cbpmckinney/ece568rockets/ground_station/pcb/ground_station.kicad_pcb

## KiCad design ground_station/pcb/ground_station.kicad_pcb (2025-05-07)

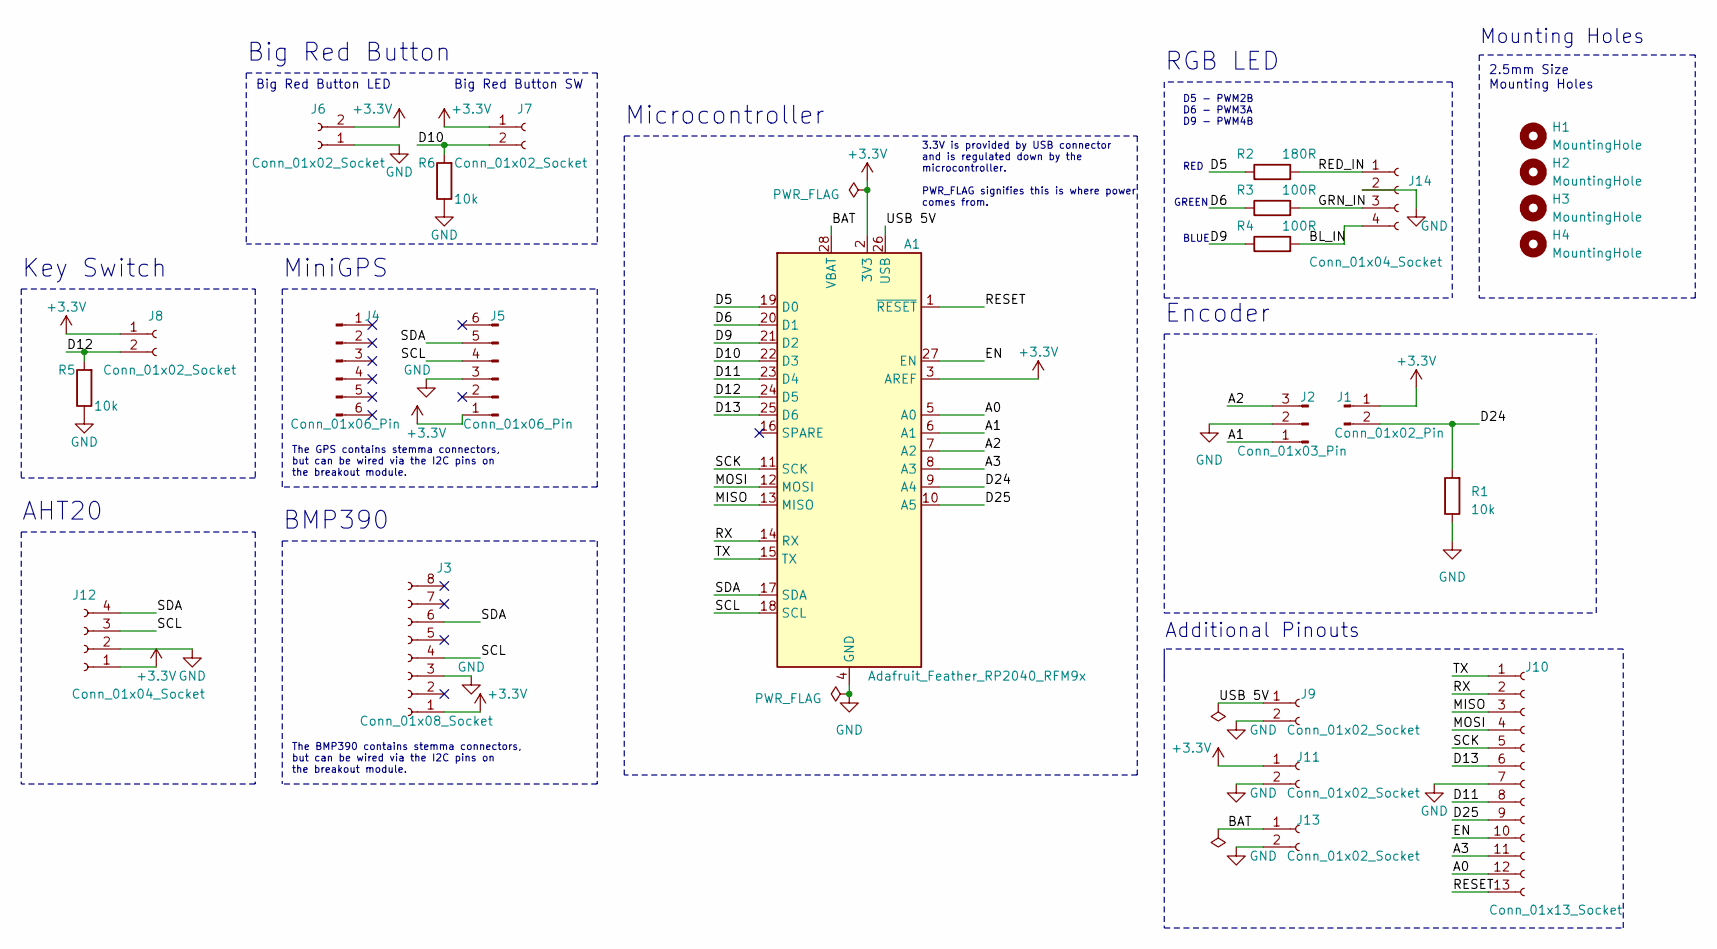
[picture p7: schematic ground_station.kicad_sch, ECE568 Ground Station]

Parts:
A1: Adafruit_Feather_RP2040_RFM9x; Adafruit_Feather
H1, H2, H3, H4: MountingHole; MountingHole_2.5mm
J1: Conn_01x02_Pin; PinHeader_1x02_P2.54mm_Vertical
J2: Conn_01x03_Pin; PinHeader_1x03_P2.54mm_Vertical
J3: Conn_01x08_Socket; PinSocket_1x08_P2.54mm_Vertical
J4, J5: Conn_01x06_Pin; PinHeader_1x06_P2.54mm_Vertical
J6, J7, J8, J9, J11, J13: Conn_01x02_Socket; PinSocket_1x02_P2.54mm_Vertical
J10: Conn_01x13_Socket; PinSocket_1x13_P2.54mm_Vertical
J12, J14: Conn_01x04_Socket; PinSocket_1x04_P2.54mm_Vertical
R1, R5, R6: 10k; R_Axial_DIN0309_L9.0mm_D3.2mm_P2.54mm_Vertical
R2: 180R; R_Axial_DIN0309_L9.0mm_D3.2mm_P2.54mm_Vertical
R3, R4: 100R; R_Axial_DIN0309_L9.0mm_D3.2mm_P2.54mm_Vertical

Connections:
+3.3V: A1.2 (3V3), A1.3 (AREF), J1.1, J3.1, J5.1, J6.2, J7.1, J8.1, J11.1, J12.1
/A0: A1.5 (A0), J10.12
/A1: A1.6 (A1), J2.1
/A2: A1.7 (A2), J2.3
/A3: A1.8 (A3), J10.11
/BAT: A1.28 (VBAT), J13.1
/BL_IN: J14.4, R4.2
/D5: A1.19 (D0), R2.1
/D6: A1.20 (D1), R3.1
/D9: A1.21 (D2), R4.1
/D10: A1.22 (D3), J7.2, R6.2
/D11: A1.23 (D4), J10.8
/D12: A1.24 (D5), J8.2, R5.2
/D13: A1.25 (D6), J10.6
/D24: A1.9 (A4), J1.2, R1.2
/D25: A1.10 (A5), J10.9
/EN: A1.27 (EN), J10.10
/GRN_IN: J14.3, R3.2
/MISO: A1.13 (MISO), J10.3
/MOSI: A1.12 (MOSI), J10.4
/RED_IN: J14.1, R2.2
/RESET: A1.1 (~RESET), J10.13
/RX: A1.14 (RX), J10.2
/SCK: A1.11 (SCK), J10.5
/SCL: A1.18 (SCL), J3.4, J5.4, J12.3
/SDA: A1.17 (SDA), J3.6, J5.5, J12.4
/TX: A1.15 (TX), J10.1
/USB 5V: A1.26 (USB), J9.1
GND: A1.4 (GND), J2.2, J3.3, J5.3, J6.1, J9.2, J10.7, J11.2, J12.2, J13.2, J14.2, R1.1, R5.1, R6.1

Notes on the sheet:
The GPS contains stemma connectors, but can be wired via the I2C pins on the breakout module.
Additional Pinouts
Big Red Button LED
RGB LED
2.5mm Size Mounting Holes
Encoder
Microcontroller
3.3V is provided by USB connector and is regulated down by the microcontroller. PWR_FLAG signifies this is where power comes from.
The BMP390 contains stemma connectors, but can be wired via the I2C pins on the breakout module.
Mounting Holes
Big Red Button
AHT20
Key Switch
BMP390
RED
GREEN
BLUE
Big Red Button SW
MiniGPS
D5 - PWM2B D6 - PWM3A D9 - PWM4B

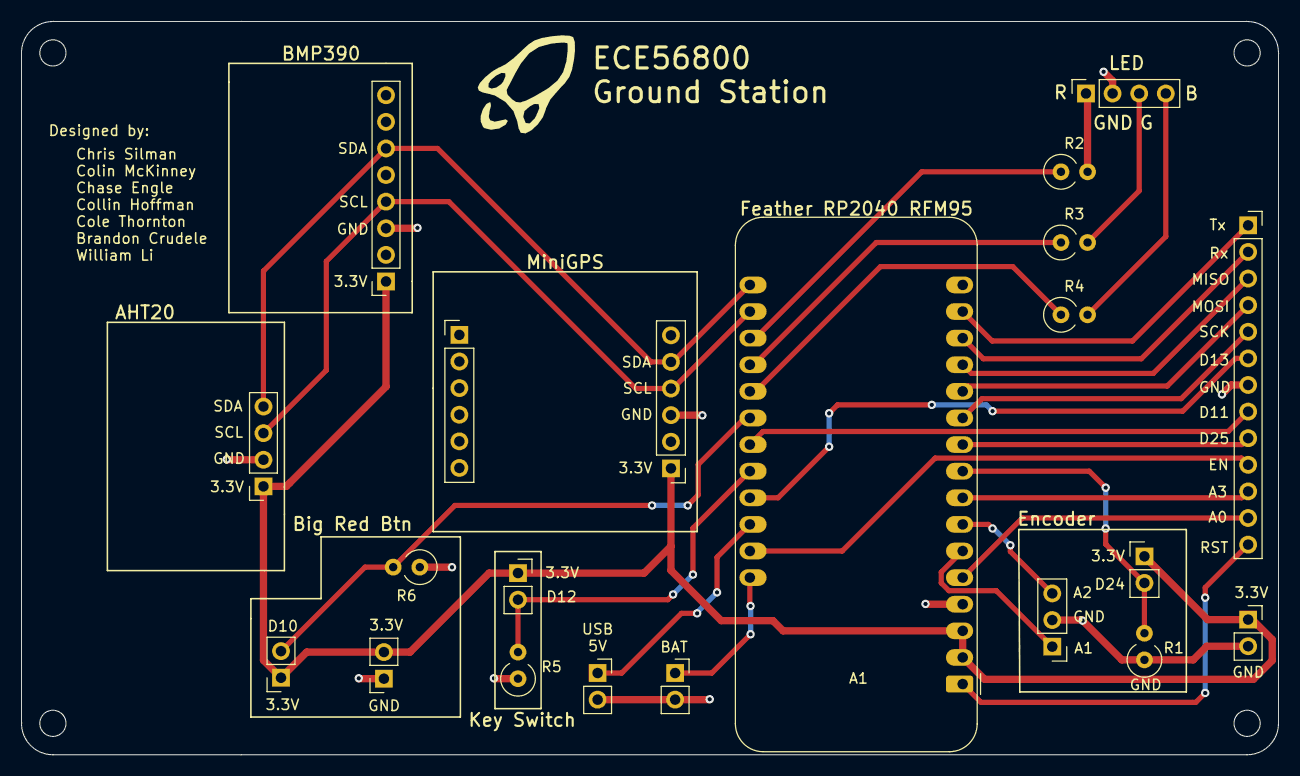
[picture p8: board ground_station.kicad_pcb from above]

Board: 2 copper layers, 120.0 x 70.0 mm, 25 parts (0 on the bottom side), 29 nets.
