cbpmckinney/ece568rockets/FlightComputer/main/main.ino

#include "main.h"
#include "Sensor.h"
#include "DOFSensor.h"
#include "altitudeSensor.h"
#include "temperatureSensor.h"
#include "RFManager.h"
#include <SPI.h>
#include <RH_RF95.h>
#include <RHReliableDatagram.h>
//#include <Wire.h>
#include <Adafruit_GPS.h>

#include <hardware/regs/m0plus.h>
#include <hardware/regs/addressmap.h>
#include <hardware/resets.h>

volatile bool ignitionFailure = false;

inline void reboot() {
    //reset USB controller
    reset_block(RESETS_WDSEL_USBCTRL_BITS);
    //you might want to add other perpherials here if you use them

    //reset the CPU
    auto & AIRCR_register = *(volatile uint32_t*)(PPB_BASE + M0PLUS_AIRCR_OFFSET);
    //From datasheet:
    //31:16 VECTKEY: On writes, write 0x05FA to VECTKEY, otherwise the write is ignored.
    //15 ENDIANESS: 0 = Little-endian.
    //14:3 Reserved
    //2 SYSRESETREQ: Writing 1 to this bit causes the SYSRESETREQ signal to the outer system to be asserted to request a reset.
    //1 VECTCLRACTIVE: not relevant here
    AIRCR_register = (0x05FA << M0PLUS_AIRCR_VECTKEY_LSB) | M0PLUS_AIRCR_SYSRESETREQ_BITS;
}



#ifdef TEST_MODE_ON_GROUND
  uint8_t simAltitude = 0;
#endif

#define DEBUG 1
#define RelayPin 25
#define GPSECHO false

Adafruit_GPS GPS(&Wire);
uint32_t timer = millis();

GPSDataStorage RocketGPSData;

void setup() {
#ifdef DEBUG
  Serial.begin(115200);

  //while (!Serial) delay(10);  // wait for serial port to open!
  
#endif
  pinMode(RelayPin, OUTPUT); // relay output pin
  digitalWrite(RelayPin, LOW); // set relay to off
  Serial.println("Initializing GPS");
  GPS.begin(0x10);
  GPS.sendCommand(PMTK_SET_NMEA_OUTPUT_RMCGGA);
  GPS.sendCommand(PMTK_SET_NMEA_UPDATE_1HZ);
  GPS.sendCommand(PGCMD_ANTENNA);
  delay(1000);
  GPS.println(PMTK_Q_RELEASE);
  // put your setup code here, to run once:
}

alarm_id_t TimerID;
int64_t RelayCallback(alarm_id_t id, void *user_data)
{
  ignitionFailure = true;
  return 0;
}



void loop() {
  static rocket_states_t currRocketState = BOOTUP;
  static sensorStatus statusByte;
  static DOFSensor dofSensor;
  static AltitudeSensor altitude_sensor;
  static TemperatureSensor temperature_sensor;
  static Sensor gps;

  static RFManager rfManager;
  static bool armCommandReceived = false;
  static bool readyCommandReceived = false;
  static bool launchCommandReceived = false;
  static bool verifyDataCommandReceived = false;
  static bool reinitializeCommandReceived = false;
  #define DEBUG 1
  #ifdef DEBUG
    static bool firstEntry = true;
  #endif

  #ifdef TEST_MODE_ON_GROUND
  static bool isFlying = false;
  static bool doneFlying = false;
  #endif

  static bool recoveryStarted = false;
  static int resetmessagecounter = 0;

  switch( currRocketState )
  {
      case POWERONFAILURE:
        #ifdef DEBUG
          Serial.println("Power On Failure...");
          Serial.println("Going back to BOOTUP");
        #endif
        currRocketState = BOOTUP;
        delay(1000);
        break;
      case BOOTUP:
        #ifdef DEBUG
          if( firstEntry )
          {
            firstEntry = false;
            Serial.println("ROCKET IN BOOTUP");

          }
        #endif
        statusByte.bits.dof_sensor         = dofSensor.initialize();   // testing without DOF
        statusByte.bits.altitude_sensor    = altitude_sensor.initialize();
        statusByte.bits.temperature_sensor = temperature_sensor.initialize();
        statusByte.bits.gps                = gps.initialize(); 
        statusByte.bits.RFtransmitter      = rfManager.initialize();
        if(statusByte.byte == 0)
        {
        #ifdef DEBUG
          firstEntry = true;
        #endif
          currRocketState = SAFE;
          Serial.println("Going to SAFE mode...");
          rfManager.sendStatus( statusByte, currRocketState );
          //currRocketState = RECOVERY; // just for testingå
        }
        else
        {
          currRocketState = POWERONFAILURE;
          Serial.println("Power On Failure...");
          rfManager.sendStatus( statusByte, currRocketState );
        }
        // THE ELSE IS ASSUMING WE WILL SEND A RADIO SIGNAL THAT SOMETHING IS WRONG
        break;

      case SAFE:
        #ifdef DEBUG
          if( firstEntry )
          {
            firstEntry = false;
            Serial.println("ROCKET IN SAFE");
          }
        #endif 

        static uint32_t timer_safe = millis();
        if (millis() - timer_safe > 1000)
        {
          rfManager.sendStatus(statusByte, currRocketState);
          timer_safe = millis();
        }


        if( rfManager.receivedCommand( ARM_PACKET ) )
        {
          Serial.println("ARM Packet Received from Ground Station");
          armCommandReceived = true;
        }
        if( armCommandReceived )
        {
          //delay(1000);
        #ifdef DEBUG
          firstEntry = true;
        #endif
          currRocketState = ARM;
          Serial.println("Sending ARM ACK to Ground Station");
          rfManager.sendStatus( statusByte, currRocketState );
        }
        break;

      case ARM:
        #ifdef DEBUG
            if( firstEntry )
            {
              firstEntry = false;
              Serial.println("ROCKET IN ARM");
              statusByte.bits.dof_sensor         = dofSensor.setInitialDataValues();
              statusByte.bits.altitude_sensor    = altitude_sensor.setInitialDataValues();
              statusByte.bits.temperature_sensor = temperature_sensor.setInitialDataValues();
              statusByte.bits.gps                = gps.setInitialDataValues();
            }
        #endif
        // receive cmd to put rocket in ready to launch mode:
        if( rfManager.receivedCommand( RTL_PACKET ) )
        {
          Serial.println("--Ready to Launch-- Packet Received from Ground Station");
          readyCommandReceived = true;
        }
        if ( readyCommandReceived ) {
          #ifdef DEBUG
            firstEntry = true;
          #endif
          currRocketState = READY_FOR_LAUNCH;
          Serial.println("Sending READY_TO_LAUNCH status to Ground Station");
          rfManager.sendStatus( statusByte, currRocketState );
        } 
        break;
      case READY_FOR_LAUNCH:
        #ifdef DEBUG
            if( firstEntry )
            {
              firstEntry = false;
              Serial.println("Ready for launch!");
            }
        #endif
        // receive cmd to put rocket in ready to launch mode:
        if( rfManager.receivedCommand( LAUNCH_PACKET ) )
          {
            Serial.println("--Launch-- Packet Received from Ground Station");
            launchCommandReceived = true;
          }
        if ( launchCommandReceived ) {
          #ifdef DEBUG
            firstEntry = true;
          #endif
          currRocketState = LAUNCH;
          Serial.println("Sending LAUNCH status to Ground Station");
          rfManager.sendStatus( statusByte, currRocketState );
          Serial.println("Launch ACK sent");
        } 
        break;


      case LAUNCH:
        //#ifdef DEBUG I need this to run regardless of debugging, so the timer only gets started once
          if ( firstEntry )
          {
            firstEntry = false;
            Serial.println("ROCKET IN LAUNCH");
            digitalWrite(RelayPin, HIGH); // fires relay
            TimerID = add_alarm_in_ms(10000, RelayCallback, NULL, false);
          }
        //#endif

        #ifdef TEST_MODE_ON_GROUND
        if( isFlying )
        {
          #ifdef DEBUG
          firstEntry = true;
          #endif
          currRocketState = FLIGHT;
          Serial.println("ROCKET IN FLIGHT");
          rfManager.sendStatus( statusByte, currRocketState );
        }
        #else
        if( dofSensor.isFlying() )
        {
          #ifdef DEBUG
            firstEntry = true;
          #endif
          currRocketState = FLIGHT;
          Serial.println("ROCKET IN FLIGHT");
          rfManager.sendStatus( statusByte, currRocketState );
        }
        #endif

        if (ignitionFailure)
        {
          digitalWrite(RelayPin, LOW);
          Serial.println("Ingition failure detected");
          currRocketState = IGNITIONFAILURE;
        }

        break;

      case FLIGHT:


          if( firstEntry )
          {
            firstEntry = false;
            Serial.println("ROCKET IN FLIGHT");
            digitalWrite(RelayPin, LOW);
            cancel_alarm(TimerID);
            rfManager.sendStatus(statusByte, currRocketState);
          }

          statusByte.bits.altitude_sensor    = altitude_sensor.collectData( );
          #ifdef TEST_MODE_ON_GROUND
          statusByte.bits.temperature_sensor = temperature_sensor.collectData( simAltitude );
          statusByte.bits.dof_sensor         = dofSensor.collectData( simAltitude );
          #else
          statusByte.bits.temperature_sensor = temperature_sensor.collectData( altitude_sensor.currAltitudeDifferenceSinceStart );
          statusByte.bits.dof_sensor         = dofSensor.collectData( altitude_sensor.currAltitudeDifferenceSinceStart );
          #endif

          statusByte.bits.gps                = gps.collectData(); // probably just velocity
        
          statusByte.bits.RFtransmitter  = rfManager.transmitData(dofSensor, altitude_sensor, temperature_sensor);
        //   COMMENT THIS NEXT SECTION OUT IF YOU ARE RUNNING ON YOUR COMPUTER ON THE GROUND OR IT WILL INSTANTLY TRANSITION
          // #ifdef TEST_MODE_ON_GROUND
          // if( doneFlying )
          // {
          //   #ifdef DEBUG
          //    firstEntry = true;
          // #endif
          //    currRocketState = RECOVERY;
          //    rfManager.sendStatus( statusByte, currRocketState );
          // }
          // #else
          if( dofSensor.doneFlying )
          {
          #ifdef DEBUG
             firstEntry = true;
          #endif
             currRocketState = RECOVERY;
             rfManager.sendStatus( statusByte, currRocketState );
          }
          // #endif
          break;
        
      case RECOVERY:
        if (!recoveryStarted)
        {
          digitalWrite(RelayPin, LOW); // make sure relay is off...should have been turned off earlier anyway
          Serial.println("Recovery Started");
          recoveryStarted = true;
          rfManager.sendStatus(statusByte, currRocketState);


        }

        if (!Serial)
        {
            Serial.begin(115200);
        }
        

        GetGPSData();
        if (RocketGPSData.latitude != 0)
        {
          rfManager.transmitGPS(RocketGPSData);
          Serial.print("Rocket LAT: ");
          Serial.print(RocketGPSData.latitude/100);
          Serial.print(" ");
          Serial.println(RocketGPSData.lat);
          Serial.print("Rocket LON: ");
          Serial.print(RocketGPSData.longitude/100);
          Serial.print(" ");
          Serial.println(RocketGPSData.lon);
          delay(1000);
        }
        //delay(2000);

        Serial.println("After recovery data dump...");
        Serial.print("Peak velocity: "); Serial.println(dofSensor.peak);
        Serial.print("Peak temperature: "); Serial.println(temperature_sensor.peakTemperature);
        Serial.print("Peak pressure: "); Serial.println(altitude_sensor.peakPressure);
        Serial.print("Peak humidity: "); Serial.println(temperature_sensor.peakHumidity);
        Serial.print("Peak index: "); Serial.println(altitude_sensor.currPressureIndex);
        delay(1000);


      #ifdef DEBUG
        if( firstEntry )
        {
          firstEntry = false;
          Serial.println("ROCKET IN RECOVERY");
        }
      #endif
        //statusByte.bits.gps = gps.getCoordinates;
        if( rfManager.receivedCommand( VERIFY_DATA ) )
        {
          verifyDataCommandReceived = true;
        }
        if( verifyDataCommandReceived )
        {
        #ifdef DEBUG
          firstEntry = true;
        #endif
          currRocketState = POST_FLIGHT;
          rfManager.sendStatus( statusByte, currRocketState );
        }
        break;

      case POST_FLIGHT:
      #ifdef DEBUG
        if( firstEntry )
        {
          firstEntry = false;
          Serial.println("ROCKET IN POST_FLIGHT");
        }
      #endif
        rfManager.retransmitData();
        if( rfManager.receivedCommand( REINITIALIZE ) )
        {
          reinitializeCommandReceived = true;
        }
        if( reinitializeCommandReceived )
        {
        #ifdef DEBUG
          firstEntry = true;
        #endif
          currRocketState = BOOTUP;
          rfManager.sendStatus( statusByte, currRocketState );
          reboot();
        }
        break;
      default:
        Serial.println("ERROR");
        break;

      case IGNITIONFAILURE:
        static uint32_t timer2 = millis();

        if (millis() - timer2 > 1000)
        {
          Serial.println("In state IGNITION FAILURE");
          rfManager.sendStatus(statusByte, currRocketState);
          timer2 = millis();
        }

        if (rfManager.receivedCommand(REINITIALIZE))
        {
          currRocketState = RESET;
          resetmessagecounter = 0;
        }

        break;

      case RESET:
        static uint32_t timer_reset = millis();
        while (resetmessagecounter < 5)
        {
          if (millis() - timer_reset > 1000)
          {
            rfManager.sendStatus(statusByte, currRocketState);
            timer_reset = millis();
            resetmessagecounter++;
          }
        }

        Serial.println("Rocket resetting in 5 seconds");
        delay(5000);
        reboot();
        break;

  }



#ifdef DEBUG
  int incomingByte = 0; // for incoming serial data
  if (Serial.available() > 0) {
      incomingByte = Serial.read();
  }
  if (incomingByte == 57) // 9 
  {
    currRocketState = RESET;
  }

  if( incomingByte == 49 ) //1
  {
    firstEntry = true;
    switch( currRocketState)
    {
      case BOOTUP:
        currRocketState = SAFE;
        break;

      case SAFE:
        currRocketState = ARM;
        break;

      case ARM:
        currRocketState = READY_FOR_LAUNCH;
        break;

      case READY_FOR_LAUNCH:
        currRocketState = LAUNCH;
        break;

      case LAUNCH:
        currRocketState = FLIGHT;
        break;

      case FLIGHT:
        currRocketState = RECOVERY;
        break;
        
      case RECOVERY:
        currRocketState = POST_FLIGHT;
        break;

      case POST_FLIGHT:
        currRocketState = RESET;
        break;
    }
  }
  #ifdef TEST_MODE_ON_GROUND
  else if( incomingByte == 50 ) //2
  {
    isFlying = true;
    Serial.print("IS FLYING: ");
    Serial.println( isFlying ? "true": "false");
  }
  else if( incomingByte == 51) //3
  {
    isFlying = false;
    Serial.print("IS FLYING: ");
    Serial.println( isFlying ? "true": "false");
  }
  else if( incomingByte == 52) //4
  {
    doneFlying = true;
    Serial.print("DONE FLYING: ");
    Serial.println( doneFlying ? "true": "false");
  }
  else if( incomingByte == 53) //5
  {
    doneFlying = false;
    Serial.print("DONE FLYING: ");
    Serial.println( doneFlying ? "true": "false");
  }
  else if( incomingByte == 54 )  //6
  {
     Serial.print("DONE FLYING: ");
     Serial.println( doneFlying ? "true": "false");
     Serial.print("IS FLYING: ");
     Serial.println( isFlying ? "true": "false");
  }
  else if( incomingByte == 55 ) //7
  {
    armCommandReceived = true;
    Serial.print("ARM COMMAND RECEIVED: ");
    Serial.println( armCommandReceived ? "true": "false");
  }
  else if( incomingByte == 56 ) //8
  {
    armCommandReceived = false;
    Serial.print("ARM COMMAND RECEIVED: ");
    Serial.println( armCommandReceived ? "true": "false");
  }
  #endif
#endif
}


void GetGPSData()
{
  // read data from the GPS in the 'main loop'
  char c = GPS.read();
  // if you want to debug, this is a good time to do it!
  if (GPSECHO)
    if (c) Serial.print(c);
  // if a sentence is received, we can check the checksum, parse it...
  if (GPS.newNMEAreceived()) {
    // a tricky thing here is if we print the NMEA sentence, or data
    // we end up not listening and catching other sentences!
    // so be very wary if using OUTPUT_ALLDATA and trying to print out data
    //Serial.println(GPS.lastNMEA()); // this also sets the newNMEAreceived() flag to false
    if (!GPS.parse(GPS.lastNMEA())) // this also sets the newNMEAreceived() flag to false
      return; // we can fail to parse a sentence in which case we should just wait for another
  }

  // approximately every 2 seconds or so, print out the current stats
  if (millis() - timer > 2000) {
    timer = millis(); // reset the timer
    Serial.print("\nTime: ");
    if (GPS.hour < 10) { Serial.print('0'); }
    Serial.print(GPS.hour, DEC); Serial.print(':');
    if (GPS.minute < 10) { Serial.print('0'); }
    Serial.print(GPS.minute, DEC); Serial.print(':');
    if (GPS.seconds < 10) { Serial.print('0'); }
    Serial.print(GPS.seconds, DEC); Serial.print('.');
    if (GPS.milliseconds < 10) {
      Serial.print("00");
    } else if (GPS.milliseconds > 9 && GPS.milliseconds < 100) {
      Serial.print("0");
    }
    Serial.println(GPS.milliseconds);
    Serial.print("Date: ");
    Serial.print(GPS.day, DEC); Serial.print('/');
    Serial.print(GPS.month, DEC); Serial.print("/20");
    Serial.println(GPS.year, DEC);
    Serial.print("Fix: "); Serial.print((int)GPS.fix);
    Serial.print(" quality: "); Serial.println((int)GPS.fixquality);
    if (GPS.fix) {
      //Serial.print("Location: ");
      //Serial.print(GPS.latitude, 4); Serial.print(GPS.lat);
      //Serial.print(", ");
      //Serial.print(GPS.longitude, 4); Serial.println(GPS.lon);
      //Serial.print("Speed (knots): "); Serial.println(GPS.speed);
      //Serial.print("Angle: "); Serial.println(GPS.angle);
      //Serial.print("Altitude: "); Serial.println(GPS.altitude);
      //Serial.print("Satellites: "); Serial.println((int)GPS.satellites);

      RocketGPSData.latitude = GPS.latitude;
      RocketGPSData.longitude = GPS.longitude;
      RocketGPSData.lat = GPS.lat;
      RocketGPSData.lon = GPS.lon;
      RocketGPSData.gpsalt = GPS.altitude;
    }
  }
}
