cbpmckinney/ece568rockets/FlightComputer/main/Sensor.cpp

#include "Sensor.h"

sensor_status_t Sensor::initialize()
{
    return SENSOR_WORKING;
}

sensor_status_t Sensor::setInitialDataValues()
{
    return SENSOR_WORKING;
}

sensor_status_t Sensor::collectData()
{
    return SENSOR_WORKING;
}
