cbpmckinney/ece568rockets/ground_station/Screen.h

#ifndef _Screen_
#define _Screen_ 

// Enum that defines all possible screens
namespace ScreenEnums {
    enum Screen {
        MENU,
        DATA,
        LAUNCH,
        LAUNCH_WAIT,
        LAUNCH_SEQ,
        LAUNCH_BIG_RED,
        LAUNCH_WRONG_PIN,
        SLEEP,
        SETTINGS,
        LOCAL,
        ROCKET,
        NONE
    };
};


#endif //_Screen_
