cbpmckinney/ece568rockets/ground_station/OLEDScreenTests.cpp

#include "OLEDScreenTests.h"

bool pinCorrect(uint8_t* pin) {
    if (pin[0] == 2 && pin[1] == 1 && pin[2] == 3)
    {
        return true;
    } else {
        return false;
    }
}

void testDataScreen(MainScreen main_screen, AuxiliaryScreen aux_screen) {
    main_screen.resetIndices();
    main_screen.showMenu();
    delay(2*DEBUG_TIME_SCALE);

    main_screen.receiveScreenInput(ENC_PRESS); // Data Screen
    delay(2*DEBUG_TIME_SCALE);

    main_screen.receiveScreenInput(ENC_PRESS); // Submit Local

    if (main_screen.request_show_data && !aux_screen.data_screen_enabled) {
        aux_screen.enableShowingData();
    } else if (!main_screen.request_show_data) {
        aux_screen.disableShowingData();
    } // else maintain current state
    aux_screen.requestScreen(main_screen.data_screen_requested);

    delay(4*DEBUG_TIME_SCALE);

    LocalSensorData testData1 = {97, 88, 102, 1};

    aux_screen.updateLocalData(testData1);

    delay(4*DEBUG_TIME_SCALE);

    LocalSensorData testData2 = {85, 88, 102, 1};

    aux_screen.updateLocalData(testData2);

    delay(4*DEBUG_TIME_SCALE);

    LocalSensorData testData3 = {85, 88, 23, 0};

    aux_screen.updateLocalData(testData3);

    delay(2*DEBUG_TIME_SCALE);

    main_screen.receiveScreenInput(ENC_PRESS); // Data Screen
    delay(1*DEBUG_TIME_SCALE);

    main_screen.receiveScreenInput(ENC_RIGHT); // Select Rocket
    delay(1*DEBUG_TIME_SCALE);

    main_screen.receiveScreenInput(ENC_PRESS); // Submit Rocket

    if (main_screen.request_show_data && !aux_screen.data_screen_enabled) {
        aux_screen.enableShowingData();
    } else if (!main_screen.request_show_data) {
        aux_screen.disableShowingData();
    } // else maintain current state
    aux_screen.requestScreen(main_screen.data_screen_requested);

    delay(4*DEBUG_TIME_SCALE);

    main_screen.receiveScreenInput(ENC_PRESS); // Data Screen
    delay(2*DEBUG_TIME_SCALE);

    main_screen.receiveScreenInput(ENC_RIGHT); // Select None
    delay(1*DEBUG_TIME_SCALE);

    main_screen.receiveScreenInput(ENC_PRESS); // Submit None

    if (main_screen.request_show_data && !aux_screen.data_screen_enabled) {
        aux_screen.enableShowingData();
    } else if (!main_screen.request_show_data) {
        aux_screen.disableShowingData();
    } // else maintain current state
    aux_screen.requestScreen(main_screen.data_screen_requested);
    
    delay(4*DEBUG_TIME_SCALE);

    main_screen.clearDisplay();
    aux_screen.clearDisplay();

}

/* Simulates screen inputs */
void testFullLaunch(MainScreen screen) {
    screen.showMenu();

    screen.receiveScreenInput(ENC_RIGHT);
    delay(1*DEBUG_TIME_SCALE);
    screen.receiveScreenInput(ENC_RIGHT);
    delay(1*DEBUG_TIME_SCALE);
    screen.receiveScreenInput(ENC_LEFT);
    delay(1*DEBUG_TIME_SCALE);
    screen.receiveScreenInput(ENC_RIGHT);
    delay(1*DEBUG_TIME_SCALE);
    screen.receiveScreenInput(ENC_RIGHT);
    delay(1*DEBUG_TIME_SCALE);
    screen.receiveScreenInput(ENC_RIGHT);
    delay(1*DEBUG_TIME_SCALE); 
    screen.receiveScreenInput(ENC_LEFT);
    delay(1*DEBUG_TIME_SCALE);
    screen.receiveScreenInput(ENC_LEFT);
    delay(1*DEBUG_TIME_SCALE);
    screen.receiveScreenInput(ENC_PRESS); // Launch Screen
    delay(4*DEBUG_TIME_SCALE);
    screen.receiveScreenInput(ENC_PRESS); // Rocket Must Be Armed Screen
    delay(10*DEBUG_TIME_SCALE);
    screen.receiveScreenInput(ENC_PRESS); // Back to Menu Screen
    delay(2*DEBUG_TIME_SCALE);
    screen.receiveScreenInput(ENC_PRESS); // Launch Screen
    delay(1*DEBUG_TIME_SCALE);
    screen.receiveScreenInput(ENC_RIGHT); // Launch - N
    delay(2*DEBUG_TIME_SCALE);
    screen.receiveScreenInput(ENC_PRESS); // Back to Menu Screen
    delay(1*DEBUG_TIME_SCALE);
    screen.receiveScreenInput(ENC_PRESS); // Launch Screen
    delay(1*DEBUG_TIME_SCALE);
    screen.receiveScreenInput(ENC_LEFT); // Launch - Y
    delay(1*DEBUG_TIME_SCALE);
    screen.rocket_armed = true; // Arm rocket for testing
    screen.receiveScreenInput(ENC_PRESS); // Launch Seq Screen
    delay(1*DEBUG_TIME_SCALE);
    screen.receiveScreenInput(ENC_RIGHT);
    delay(1*DEBUG_TIME_SCALE);
    screen.receiveScreenInput(ENC_RIGHT);
    delay(1*DEBUG_TIME_SCALE);
    screen.receiveScreenInput(ENC_LEFT);
    delay(1*DEBUG_TIME_SCALE);
    screen.receiveScreenInput(ENC_PRESS); // Pin value 1 submitted  (1)
    delay(1*DEBUG_TIME_SCALE);
    screen.receiveScreenInput(ENC_LEFT);
    delay(1*DEBUG_TIME_SCALE);
    screen.receiveScreenInput(ENC_RIGHT);
    delay(1*DEBUG_TIME_SCALE);
    screen.receiveScreenInput(ENC_PRESS); // Pin value 2 submitted (1)
    delay(1*DEBUG_TIME_SCALE);
    screen.receiveScreenInput(ENC_RIGHT);
    delay(1*DEBUG_TIME_SCALE);
    screen.receiveScreenInput(ENC_RIGHT);
    delay(1*DEBUG_TIME_SCALE);
    screen.receiveScreenInput(ENC_RIGHT);
    delay(1*DEBUG_TIME_SCALE);
    screen.receiveScreenInput(ENC_PRESS); // Pin value 3 submitted (3)
    delay(4*DEBUG_TIME_SCALE);

    // We are now about to submit pin TO verify validity
    // MEANT TO BE INCORRECT HERE
    screen.key_inserted = true;
    uint8_t* pin = screen.getInputPin();

    Serial.print("Checking pin...");

    if (pinCorrect(pin)) {
        Serial.println("Pin correct!");
        screen.pin_correct = true;
    } else {
        Serial.println("Pin incorrect!");
    }

    screen.receiveScreenInput(ENC_PRESS); // Submit pin, go to pin incorrect screen
    delay(4*DEBUG_TIME_SCALE);
    screen.receiveScreenInput(ENC_PRESS); // Go back to menu screen
    delay(2*DEBUG_TIME_SCALE);
    screen.receiveScreenInput(ENC_PRESS); // Launch Screen
    delay(1*DEBUG_TIME_SCALE);
    screen.receiveScreenInput(ENC_LEFT); // Launch - Y
    delay(1*DEBUG_TIME_SCALE);
    //screen.rocket_armed = true;         -- ALREADY ARMED
    screen.receiveScreenInput(ENC_PRESS); // Launch Seq Screen
    delay(1*DEBUG_TIME_SCALE);
    screen.receiveScreenInput(ENC_RIGHT);
    delay(1*DEBUG_TIME_SCALE);
    screen.receiveScreenInput(ENC_PRESS); // Pin value 1 submitted  (2)
    delay(1*DEBUG_TIME_SCALE);
    screen.receiveScreenInput(ENC_PRESS); // Pin value 2 submitted (1)
    delay(1*DEBUG_TIME_SCALE);
    screen.receiveScreenInput(ENC_PRESS); // Pin value 3 submitted (3)
    delay(4*DEBUG_TIME_SCALE);

    // We are now about to submit pin TO verify validity
    // MEANT TO BE CORRECT HERE
    screen.key_inserted = true;
    pin = screen.getInputPin();

    Serial.print("Checking pin...");

    if (pinCorrect(pin)) {
        Serial.println("Pin correct!");
        screen.pin_correct = true;
    } else {
        Serial.println("Pin incorrect!");
    }

    screen.receiveScreenInput(ENC_PRESS); // Submit pin, go to btn launch screen
    delay(4*DEBUG_TIME_SCALE);
    screen.receiveScreenInput(ENC_PRESS); // Go back to menu screen
    delay(2*DEBUG_TIME_SCALE);
    
    Serial.println("Wrote!");

    screen.clearDisplay();
}
