cbpmckinney/ece568rockets/ground_station/OLEDScreenTests.h

#ifndef _OLEDScreenTests_
#define _OLEDScreenTests_

#define DEBUG_TIME_SCALE 500

#include "MainScreen.h"
#include "AuxiliaryScreen.h"

void testDataScreen(MainScreen m_screen, AuxiliaryScreen a_screen);
void testFullLaunch(MainScreen screen);

#endif //_OLEDScreenTests_
