cbpmckinney/ece568rockets/(commit log)

2025-03-22 Added initial files and framework of the classes for OLED
2025-03-24 Added the foundation for screen manipulation, still missing major components but most functions even if empty are present
    [main.ino]
2025-03-25 Added start of receiving encoder press
2025-03-26 Cursor currently broken, however, controlling screen jumps should be very easy with the current method. Drawing the cursor in the correct spot is the next difficult challenge.
    [main.ino]
2025-03-27 initial commit for flight computer ino file and sensor class
2025-03-29 Added inputing pin functionality. Need to shrink duplicate code
2025-03-29 Finished out LAUNCH_SEQ page allowing user to submit pin. Protection control is expected outside OLED class.
2025-03-29 Added incorrect pin screen when pin is entered incorrectly
2025-03-29 Added red button launch screen
2025-03-29 Moved tests to different files, fixed index issues with pin inserting, added comments to better clarity
    [MainScreen.cpp, MainScreen.h, OLEDScreenTests.cpp, OLEDScreenTests.h, main.ino]
2025-03-29 Added capability to reset indices for testing purposes
    [MainScreen.cpp, MainScreen.h, OLEDScreenTests.cpp, main.ino]
2025-03-29 This works very well for collecting all the data that we want on the DOF sensor
2025-03-30 Added encoder functionality
2025-03-30 Cleaned up code a bit (much more to do) and set up encoder to connect inputs to screen
2025-03-30 Fixed encoder not properly being sent to mainscreen, should be much smoother now
    [main.ino]
2025-03-30 Implemented encoder button press
2025-04-01 Fixed some compilation errors
    [main.ino]
2025-04-04 Corrected spelling of Auxiliary
    [AuxiliaryScreen.cpp, AuxiliaryScreen.h, OLEDScreenTests.cpp, OLEDScreenTests.h]
2025-04-04 Fixed auxiliary spelling in main as well
    [main.ino]
2025-04-04 Initial PCB design
    [4884 Feather RP2040.step, ground_station.kicad_pcb, ground_station.kicad_sch]
2025-04-07 Updated file structure
    [4884 Feather RP2040.step, ground_station.kicad_pcb, ground_station.kicad_sch]
2025-04-07 Removed PCB stuff from branch
2025-04-07 Added peripheral inputs for button and key switch as well as LED control
2025-04-08 Added initial relay code to flight computer
2025-04-10 RF Ground Functions
2025-04-10 Fix Incomplete ACK Bug
    [RF_rocket.ino]
2025-04-11 Completed tracing work
    [ground_station.kicad_pcb, ground_station.kicad_sch]
2025-04-12 Pushed manufacturing files
    [ground_station-B_Cu.gbr, ground_station-B_Mask.gbr, ground_station-B_Paste.gbr, ground_station-B_Silkscreen.gbr, ground_station-Edge_Cuts.gbr, ground_station-F_Cu.gbr, ground_station-F_Mask.gbr, ground_station-F_Paste.gbr]
2025-04-14 Added Ground V2 with RF that sorta works...maybe.
2025-04-15 This should fix the altitude code and add some useful debugging tools to the repo
    [DOFSensor.cpp, RFManager.cpp, RFManager.h, altitudeSensor.cpp, altitudeSensor.h, main.h, main.ino]
2025-04-16 Removed sensor files temporarily, just working on getting RF situated
2025-04-17 Re-added additional files as radio doesn't work without them. Removed some print statements
    [AuxiliaryScreen.cpp, DOFSensor.cpp, DOFSensor.h, Sensor.cpp, Sensor.h, altitudeSensor.cpp, altitudeSensor.h, ground_station.ino]
2025-04-17 Fixed RFManager.init() being commented out
    Not to name names, but...
    [main.ino]
2025-04-18 First commit with reading local data sensors
2025-04-18 Fixed screen updated even when it is not the screen displaying
    [AuxiliaryScreen.cpp, LocalDataSensors.cpp]
2025-04-19 Cleaned up prints, cleaned up debug, fixed some issues and corrected screen displaying
    [AuxiliaryScreen.cpp, AuxiliaryScreen.h, LocalDataSensors.cpp, MainScreen.cpp, ground_station.ino]
2025-04-19 Cleaned up more print statements, added a few comments
2025-04-19 Got lots of RF code working on ground side
    Awesome stuff
2025-04-21 Relay stuff
    Added one shot interrupt based timer so the relay will turn off after 5 seconds or when the rocket moves into flight, whichever comes first
2025-04-21 Updated code
    Had to disable some of Chris' state switching override code and go back to the manual version, because of RF and the ACK packets. Basically the radio buffer would get confused if we weren't checking for an ACK. I should probably re-write the getStatus thing to not have the publicly accessible statbuf...it's horrible.
    Functionality with the actual button, rotary encoder, etc. was a little finicky, and occasionally the board seems to lock up when switching states (screen code?). It might also just be the wiring mess and such, which the PCB will hopefully fix.
    I think we may be missing pinMode() calls in setup().
    So far the rocket can (if ground test override applied) make it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
    [RFManager.cpp, ground_station.ino, main.ino]
2025-04-21 Added functions for GPS transmission
    GPS now sorta works on flight and ground. When in recovery, flight periodically sends GPS data to ground over RF.
    Needs more testing.
2025-04-22 Update main.ino
    Removed auto-switch to RECOVERY for now
2025-04-25 Flight test updates
    Changed to flight mode, not test on ground. Uncommented out transition code needed. Added some printing statements for testing
2025-04-25 Swapped OLED screen addresses and updated GPS lat and long to have properly display coordinates with reduced decimal places
    [LocalDataSensors.cpp, ground_station.ino]
2025-04-25 Reset functions and ignition failure logic
    Added reboot() function and worked on a lot of RF/other stuff for ground/flight to recognize and handle ignition failures/reset commands
    [RFManager.cpp, RFManager.h, ground_station.ino, main.h, main.ino]
2025-04-26 Work
    Working on ground station to use actual key and pin, and rocket side to send SAFE message once per second
2025-04-26 Added some debugging for mainscreen pin behavior
2025-04-26 Added key check to ARM state
2025-04-26 Fixed PIN issue
    Fixed PIN issue and also made it so that RTL packet isn't spammed to the rocket
    [ground_station.ino]
2025-04-28 Updates for flight testing
    Added bool to altitude sensor so peak pressure is actually min pressure. Verified with Chase that code is configured for live testing.
